highno/peepoo/README.md

# PeePoo

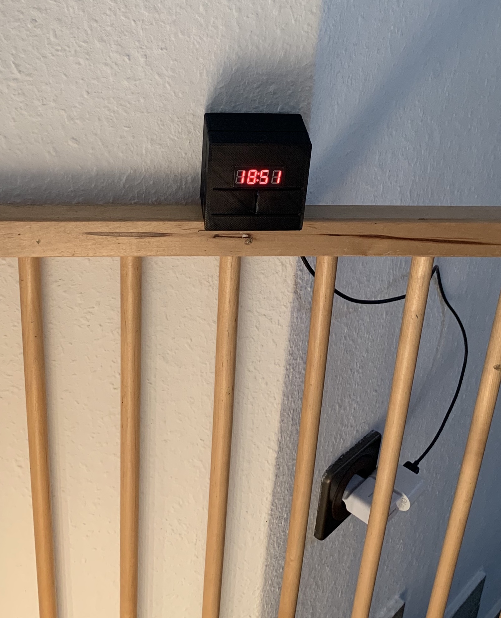
[picture p1: docs/Natürliches Habitat.jpg]


PeePoo ist ein Lernprojekt um den DigiSpark kennenzulernen. Es begleitet den Leser/Umsetzer von Null an bis zum fertigen "Produkt" mit Sourcecode, Bauteilen und einem praktisch orientierten Gehäuse. Man benötigt kein tiefes Wissen aber mit einem Arduino sollte man schon mal gearbeitet haben (und natürlich C können).

Die Anleitung befindet sich unter [docs/PeePoo.md](docs/PeePoo.md).

Das fertige Produkt ist hier zu bewundern: https://youtu.be/w1qvbLcAaJ8
