highno/peepoo/docs/Analoge Messwerte ohne Taste.jpg

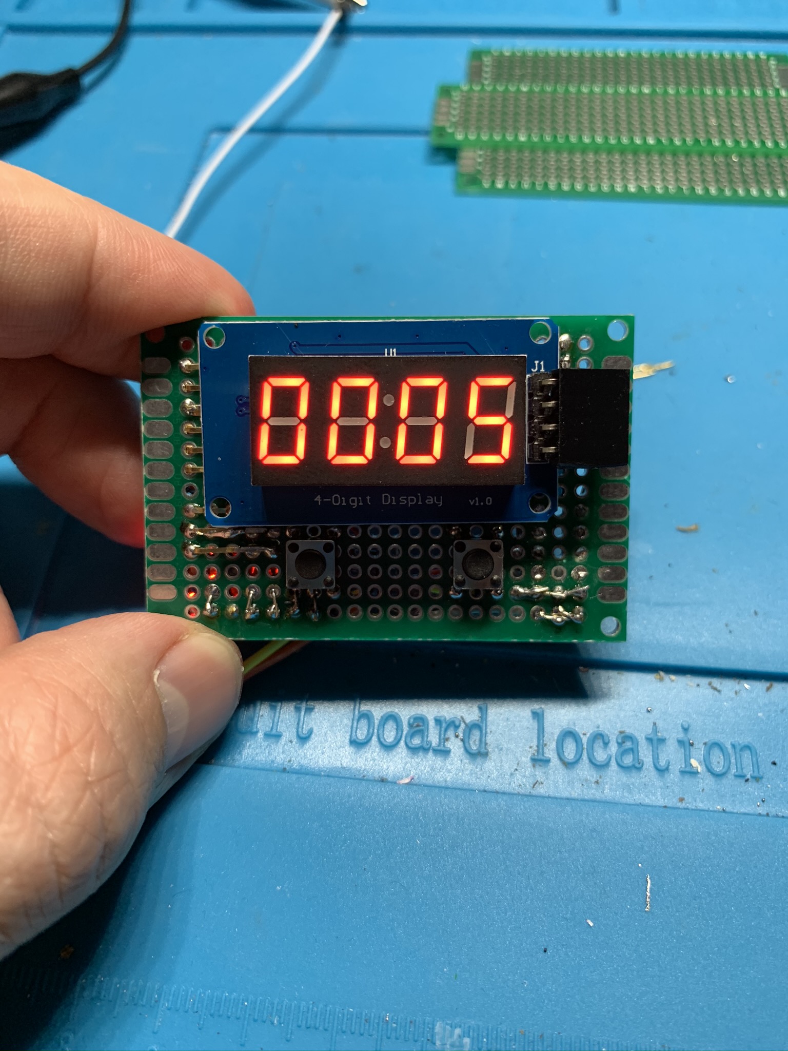
docs/Analoge Messwerte ohne Taste.jpg
