highno/peepoo/docs/Anschluss Display.jpg

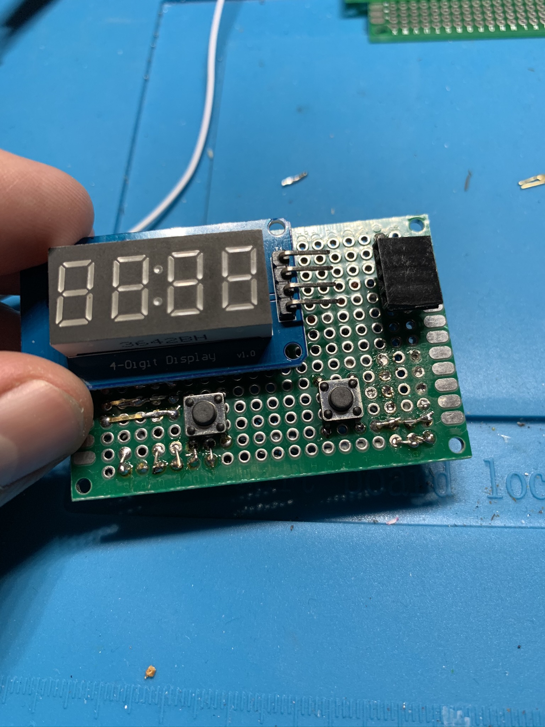
docs/Anschluss Display.jpg
