highno/peepoo/docs/Anschluss RTC.jpg

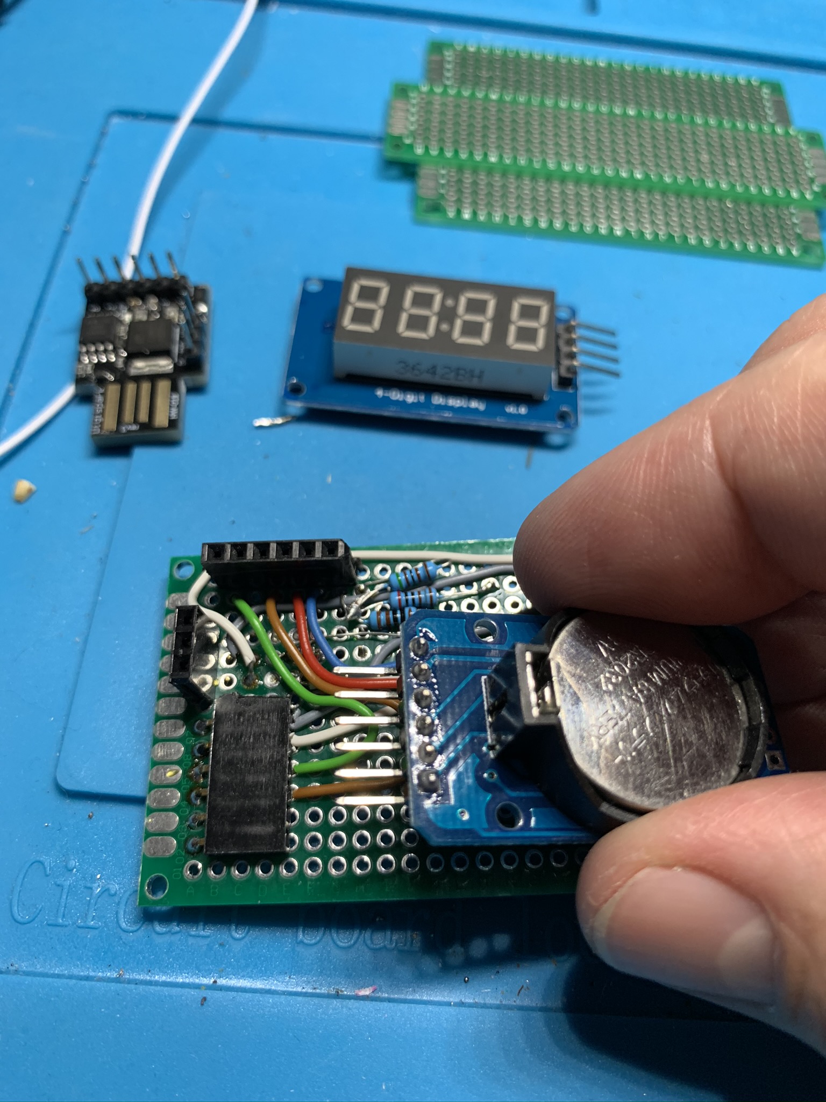
docs/Anschluss RTC.jpg
