highno/peepoo/docs/Das fertige Gehäuse.jpg

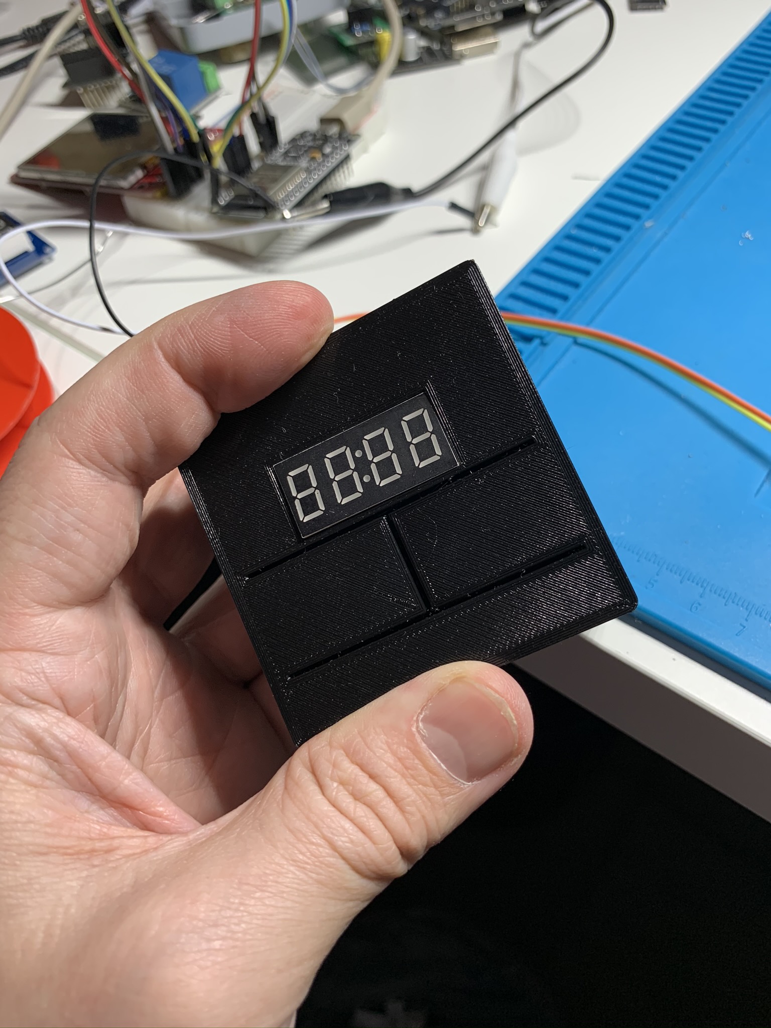
docs/Das fertige Gehäuse.jpg
