highno/peepoo/docs/Gehäusefront mit Display.jpg

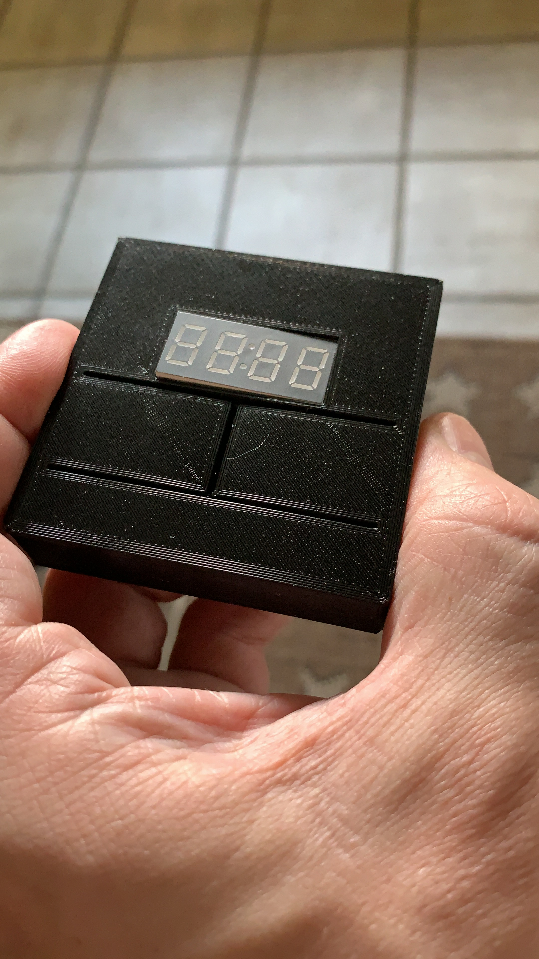
docs/Gehäusefront mit Display.jpg
