highno/peepoo/docs/Gehäuseoberteil mit Platine.jpg

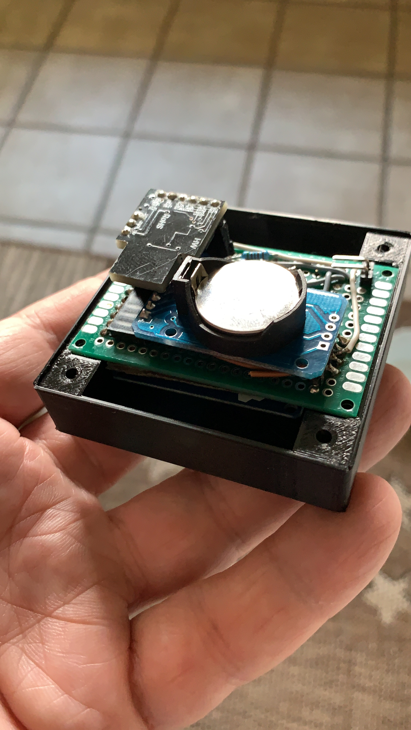
docs/Gehäuseoberteil mit Platine.jpg
