highno/peepoo/docs/Platine mit Baugruppen von unten.jpg

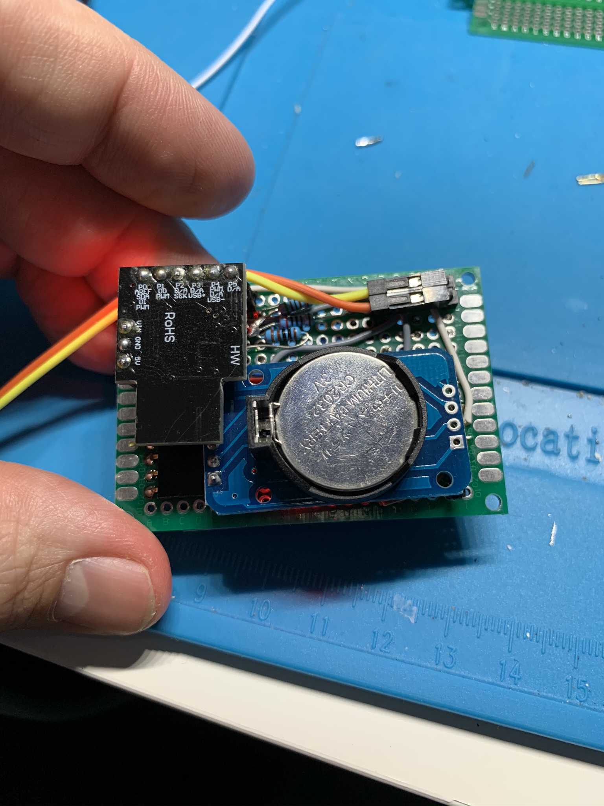
docs/Platine mit Baugruppen von unten.jpg
