highno/peepoo/(commit log)

2020-05-29 Docs und Fotos ergänzt
2020-05-30 Beschriftungen der Bilder eingefügt
